Phylakes01/Captone-esp-32-Scematics-and-IOT-code/(commit log)

2026-10-25 add modular firmware files and main application for ESP32 capstone project
2026-10-25 Add schematic image and update documentation
2026-10-31 refactor: add calibration, validation, and error handling to sensor modules and config
    [ap_mode.h, bh1750_sensor.h, config.h, dht22_sensor.h, soil_sensor.h, system_utils.h]
